h4ctar/motorbike-speedo/speedo-pcb/speedo-pcb.kicad_pcb

## KiCad design speedo-pcb/speedo-pcb.kicad_pcb (2025-04-23)

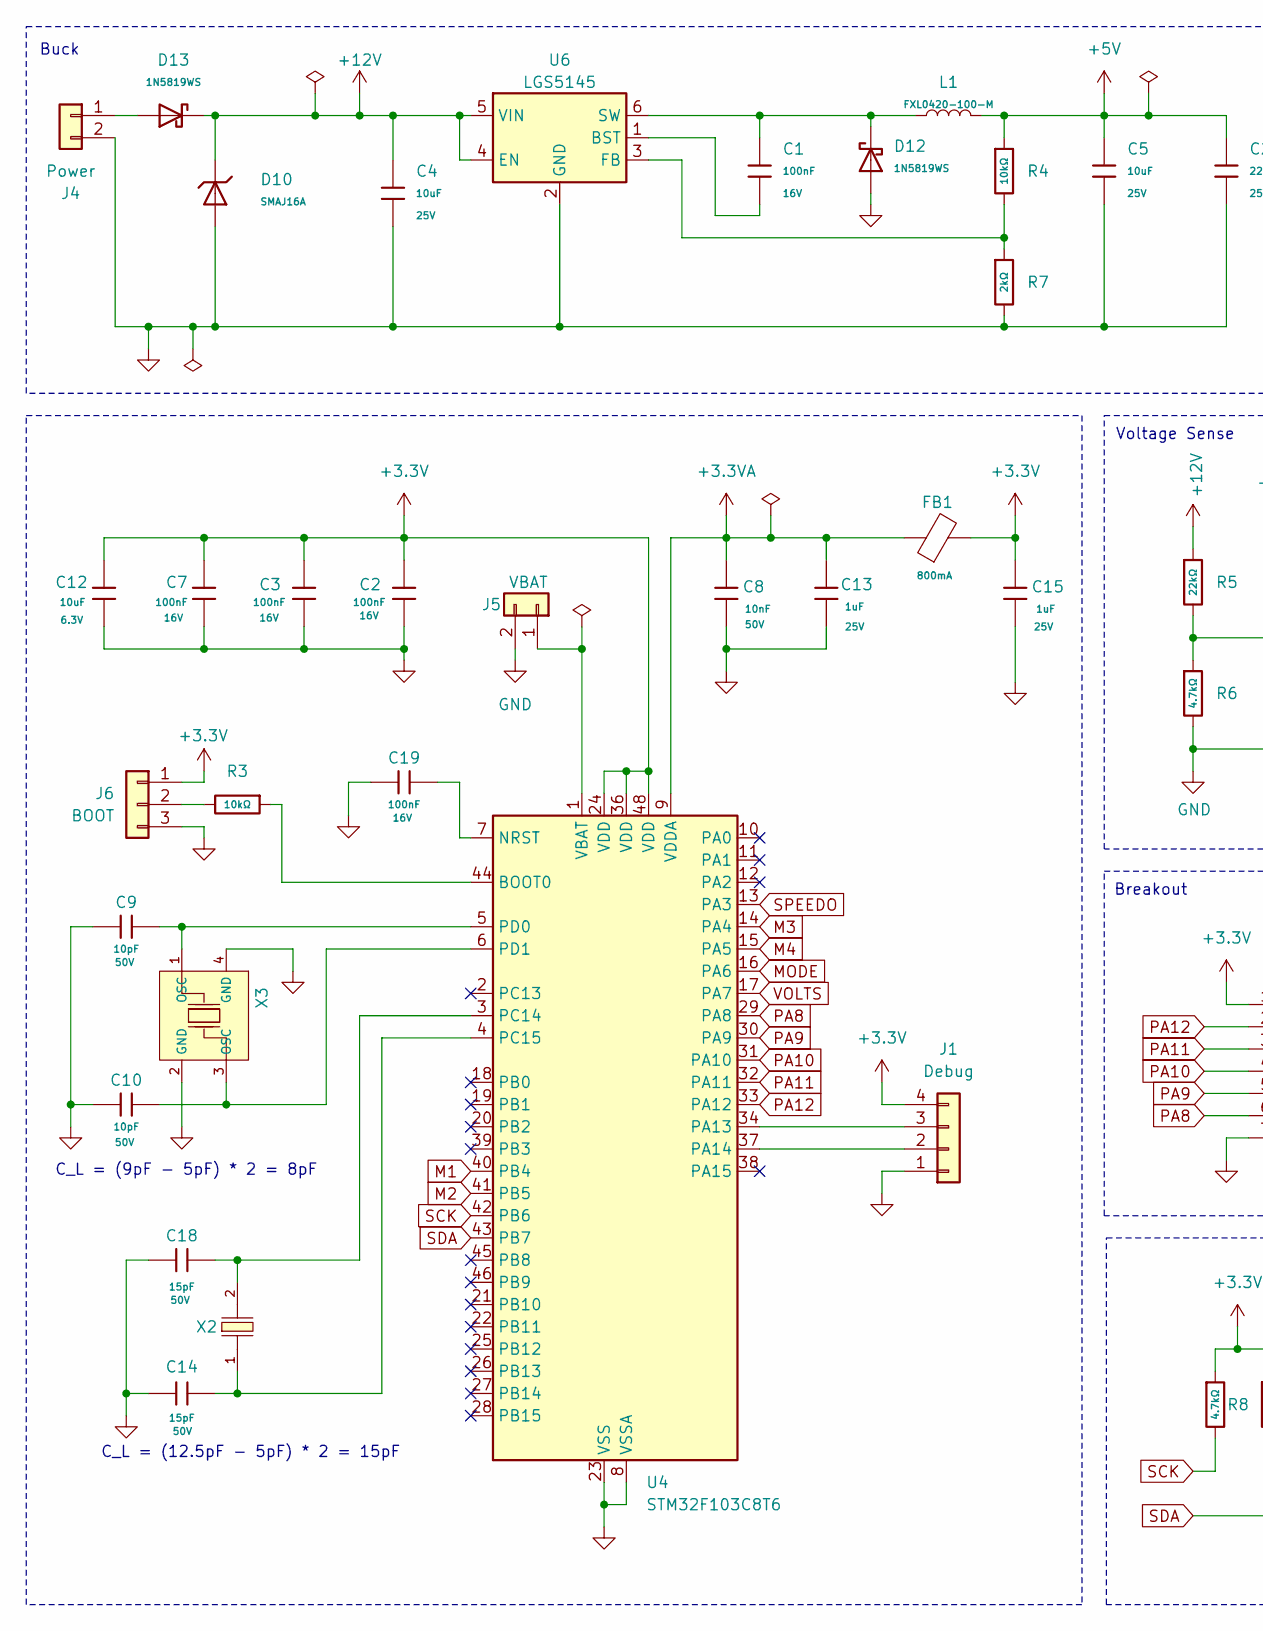
[picture p1: schematic speedo-pcb.kicad_sch, Motorcycle Speedo, part in row 1, column 1]

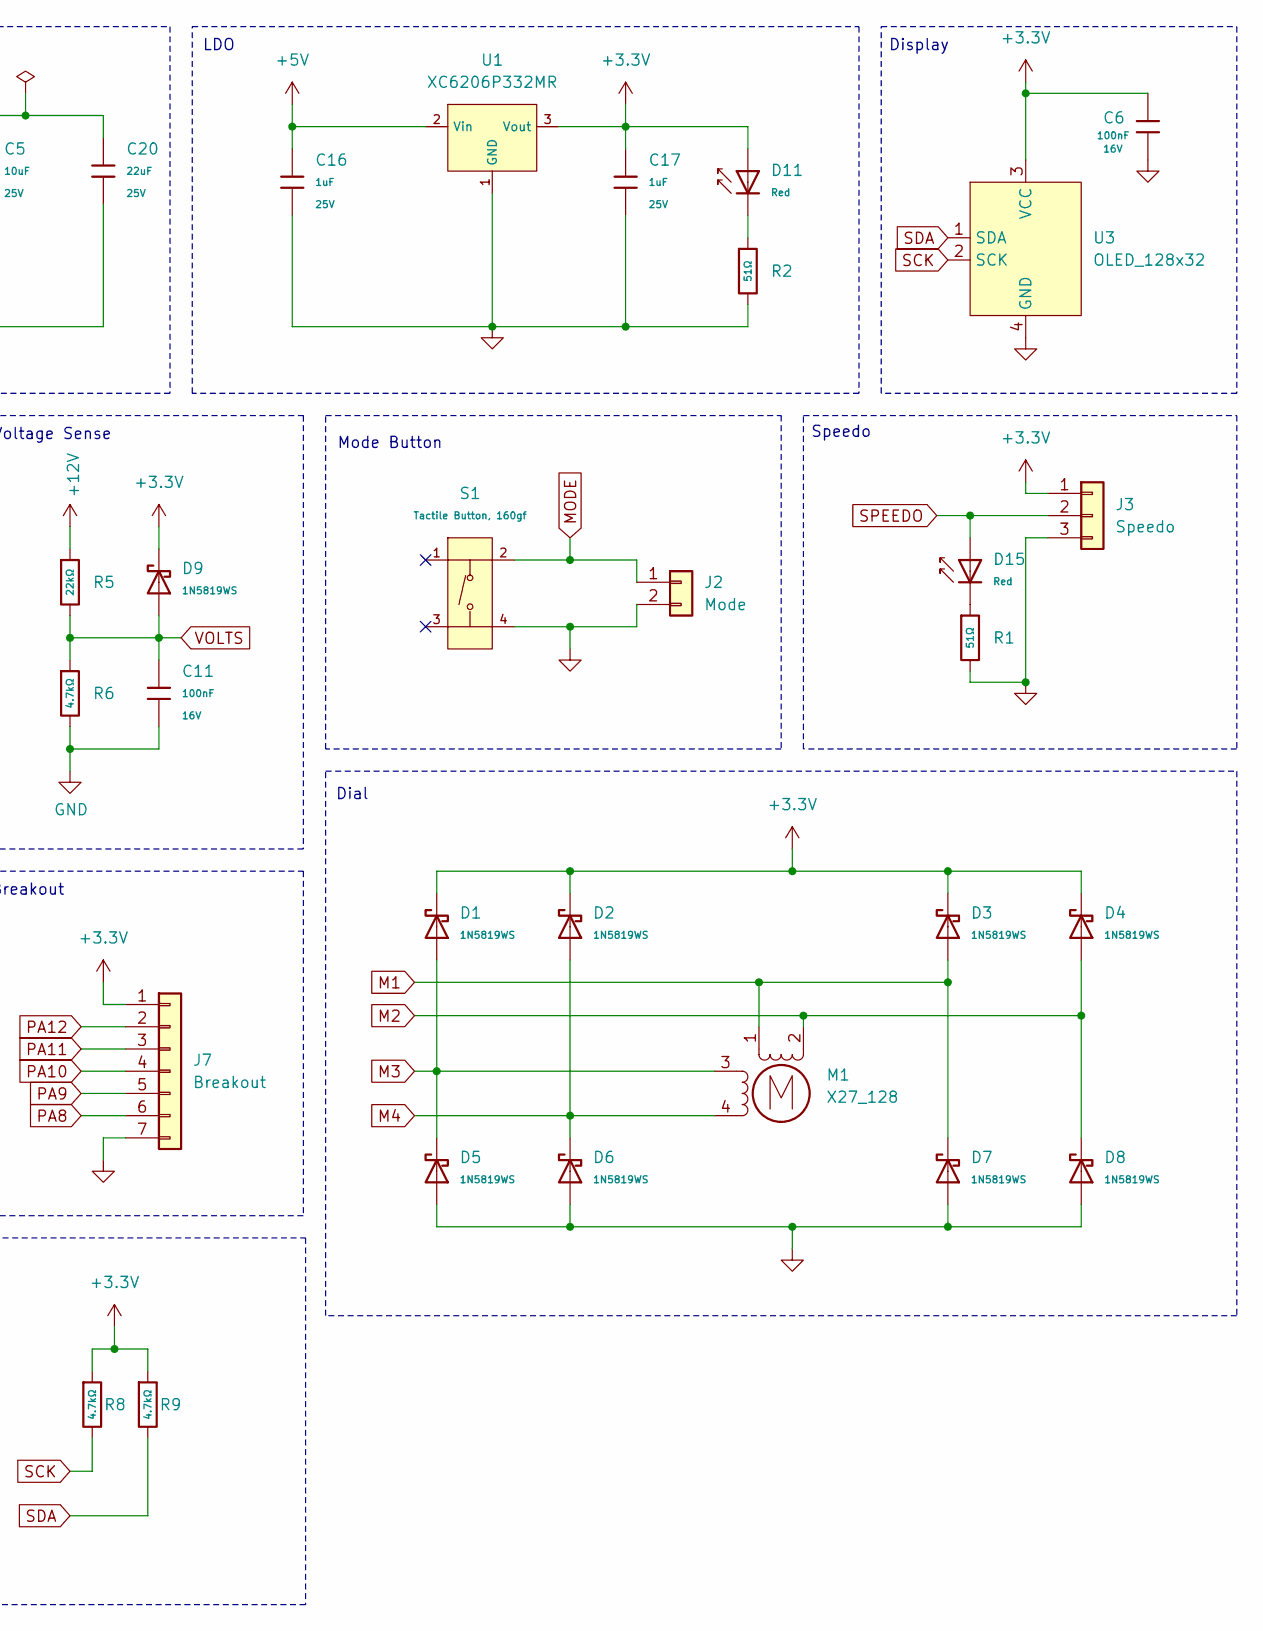
[picture p2: schematic speedo-pcb.kicad_sch, Motorcycle Speedo, part in row 1, column 2]

Parts:
C1, C2, C3, C6, C7, C11, C19: 100nF; C_0402; Voltage Rated 16V; Tolerance ±10%; Part CL05B104KO5NNNC; LCSC C1525
C4, C5: 10uF; C_0805; Voltage Rated 25V; Tolerance ±10%; Part CL21A106KAYNNNE; LCSC C15850
C8: 10nF; C_0402; Voltage Rated 50V; Tolerance ±10%; Part CL05B103KB5NNNC; LCSC C15195
C9, C10: 10pF; C_0402; Voltage Rated 50V; Tolerance ±5%; Part CL05C100JB5NNNC; LCSC C32949
C12: 10uF; C_0402; Voltage Rated 6.3V; Tolerance ±20%; Part CL05A106MQ5NUNC; LCSC C15525
C13, C15, C16, C17: 1uF; C_0402; Voltage Rated 25V; Tolerance ±10%; Part CL05A105KA5NQNC; LCSC C52923
C14, C18: 15pF; C_0402; Voltage Rated 50V; Tolerance ±5%; Part 0402CG150J500NT; LCSC C1548
C20: 22uF; C_0805; Voltage Rated 25V; Tolerance ±20%; Part CL21A226MAQNNNE; LCSC C45783
D1, D2, D3, D4, D5, D6, D7, D8, D9, D12, D13: 1N5819WS; D_SOD-323; Forward Voltage (Vf@If) 600mV@1A; Reverse Voltage (Vr) 40V; Part 1N5819WS; LCSC C191023
D10: SMAJ16A; D_SMA; Breakdown Voltage 19.7V; Part SMAJ16A; LCSC C41376405
D11, D15: Red; D_0603; Part KT-0603R; LCSC C2286
FB1: FB_0805; Current Rating 800mA; Tolerance ±25%; Part GZ2012D101TF; LCSC C1015
J1: Debug; PinHeader_1x04_P2.54mm_Vertical
J2: Mode; JST_PH_B2B-PH-K_1x02_P2.00mm_Vertical
J3: Speedo; JST_PH_B3B-PH-K_1x03_P2.00mm_Vertical
J4: Power; JST_PH_B2B-PH-K_1x02_P2.00mm_Vertical
J5: VBAT; JST_PH_B2B-PH-K_1x02_P2.00mm_Vertical
J6: BOOT; PinHeader_1x03_P2.54mm_Vertical
J7: Breakout; PinSocket_1x07_P2.54mm_Vertical
L1: FXL0420-100-M; L_Sunlord_MWSA0402S; LCSC C177242
M1: X27_128; X27_168
R1, R2: 51Ω; R_0402; Overload Voltage (Max) 50V; Tolerance ±1%; Part 0402WGF510JTCE; LCSC C25125
R3, R4: 10kΩ; R_0402; Overload Voltage (Max) 50V; Tolerance ±1%; Part 0402WGF1002TCE; LCSC C25744
R5: 22kΩ; R_0402; Overload Voltage (Max) 50V; Tolerance ±1%; Part 0402WGF2202TCE; LCSC C25768
R6, R8, R9: 4.7kΩ; R_0402; Overload Voltage (Max) 50V; Tolerance ±1%; Part 0402WGF4701TCE; LCSC C25900
R7: 2kΩ; R_0402; Overload Voltage (Max) 50V; Tolerance ±1%; Part 0402WGF2001TCE; LCSC C4109
S1: Tactile Button, 160gf; SW-SMD_4P-L5.1-W5.1-P3.70-LS6.5-TL-2; Voltage Rating (Dc) 12V; Part TS-1187A-B-A-B; LCSC C318884
U1: XC6206P332MR; SOT-23-3_L2.9-W1.6-P1.90-LS2.8-BR; Output Voltage 3.3V; Dropout Voltage 680mV@(100mA); Part XC6206P332MR-G; LCSC C5446
U3: OLED_128x32; OLED_128_32
U4: STM32F103C8T6; LQFP-48_7x7mm_P0.5mm; Operating Voltage Range 2V~3.6V; Low Voltage Detection T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 2V~3.6V; Part STM32F103C8T6; LCSC C8734
U6: LGS5145; SOT-23-6; LCSC C5123971
X2: Q13FC1350000400; FC-135R_L3.2-W1.5; Frequency Tolerance ±20ppm; Part Q13FC13500004; LCSC C32346
X3: X322516MLB4SI; OSC-SMD_4P-L3.2-W2.5-BL; Frequency Tolerance ±10ppm; Part X322516MLB4SI; LCSC C13738

Connections:
+3.3V: C2.1, C3.1, C6.1, C7.1, C12.1, C15.1, C17.1, D1.1, D2.1, D3.1, D4.1, D9.1, D11.2, FB1.2, J1.4, J3.1, J6.1, J7.1, R8.1, R9.1, U1.3 (Vout), U3.3 (VCC), U4.24 (VDD), U4.36 (VDD), U4.48 (VDD)
+3.3VA: C8.1, C13.1, FB1.1, U4.9 (VDDA)
+5V: C5.1, C16.1, C20.1, L1.2, R4.1, U1.2 (Vin)
+12V: C4.1, D10.1, D13.1, R5.1, U6.4 (EN), U6.5 (VIN)
GND: C2.2, C3.2, C4.2, C5.2, C6.2, C7.2, C8.2, C9.1, C10.1, C11.2, C12.2, C13.2, C14.1, C15.2, C16.2, C17.2, C18.1, C19.1, C20.2, D5.2, D6.2, D7.2, D8.2, D10.2, D12.2, J1.1, J2.2, J3.3, J4.2, J5.2, J6.3, J7.7, R1.2, R2.2, R6.2, R7.2, S1.4 (D), U1.1 (GND), U3.4 (GND), U4.8 (VSSA), U4.23 (VSS), U4.35 (VSS), U4.47 (VSS), U6.2 (GND), X3.2 (GND), X3.4 (GND)
M1: D3.2, D7.1, M1.1, U4.40 (PB4)
M2: D4.2, D8.1, M1.2 (-), U4.41 (PB5)
M3: D1.2, D5.1, M1.3, U4.14 (PA4)
M4: D2.2, D6.1, M1.4, U4.15 (PA5)
MODE: J2.1, S1.2 (B), U4.16 (PA6)
unnamed: D11.1, R2.1
unnamed: D15.1, R1.1
unnamed: J1.2, U4.37 (PA14)
unnamed: J1.3, U4.34 (PA13)
unnamed: D13.2, J4.1
unnamed: J5.1, U4.1 (VBAT)
unnamed: J6.2, R3.2
unnamed: R3.1, U4.44 (BOOT0)
unnamed: C19.2, U4.7 (NRST)
unnamed: C18.2, U4.3 (PC14), X2.2
unnamed: C14.2, U4.4 (PC15), X2.1
unnamed: C9.2, U4.5 (PD0), X3.1 (OSC)
unnamed: C10.2, U4.6 (PD1), X3.3 (OSC)
unnamed: C1.1, U6.1 (BST)
unnamed: R4.2, R7.1, U6.3 (FB)
unnamed: C1.2, D12.1, L1.1, U6.6 (SW)
PA8: J7.6, U4.29 (PA8)
PA9: J7.5, U4.30 (PA9)
PA10: J7.4, U4.31 (PA10)
PA11: J7.3, U4.32 (PA11)
PA12: J7.2, U4.33 (PA12)
SCK: R8.2, U3.2 (SCK), U4.42 (PB6)
SDA: R9.2, U3.1 (SDA), U4.43 (PB7)
SPEEDO: D15.2, J3.2, U4.13 (PA3)
VOLTS: C11.1, D9.2, R5.2, R6.1, U4.17 (PA7)

Notes on the sheet:
LDO
Dial
Speedo
C_L = (9pF - 5pF) * 2 = 8pF
C_L = (12.5pF - 5pF) * 2 = 15pF
Display
Buck
Breakout
Mode Button
Voltage Sense

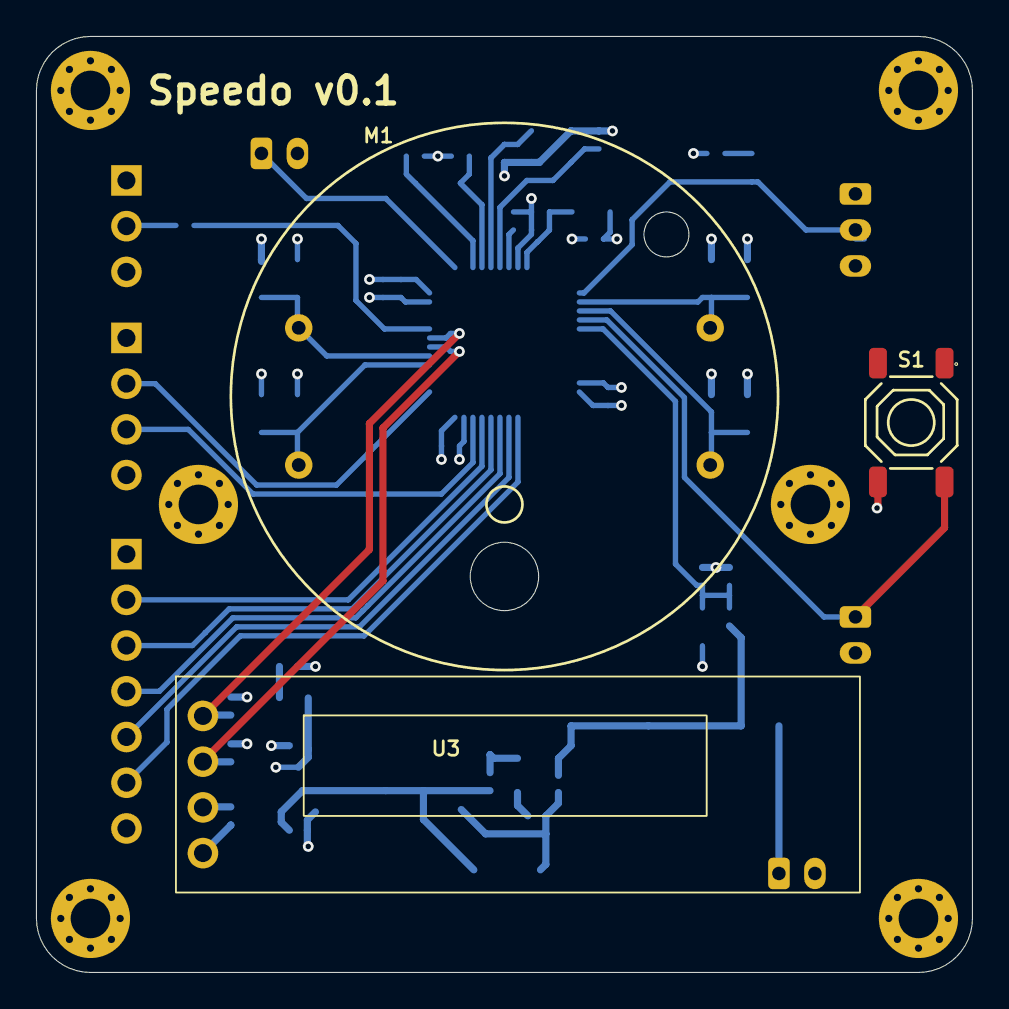
[picture p3: board speedo-pcb.kicad_pcb from above]

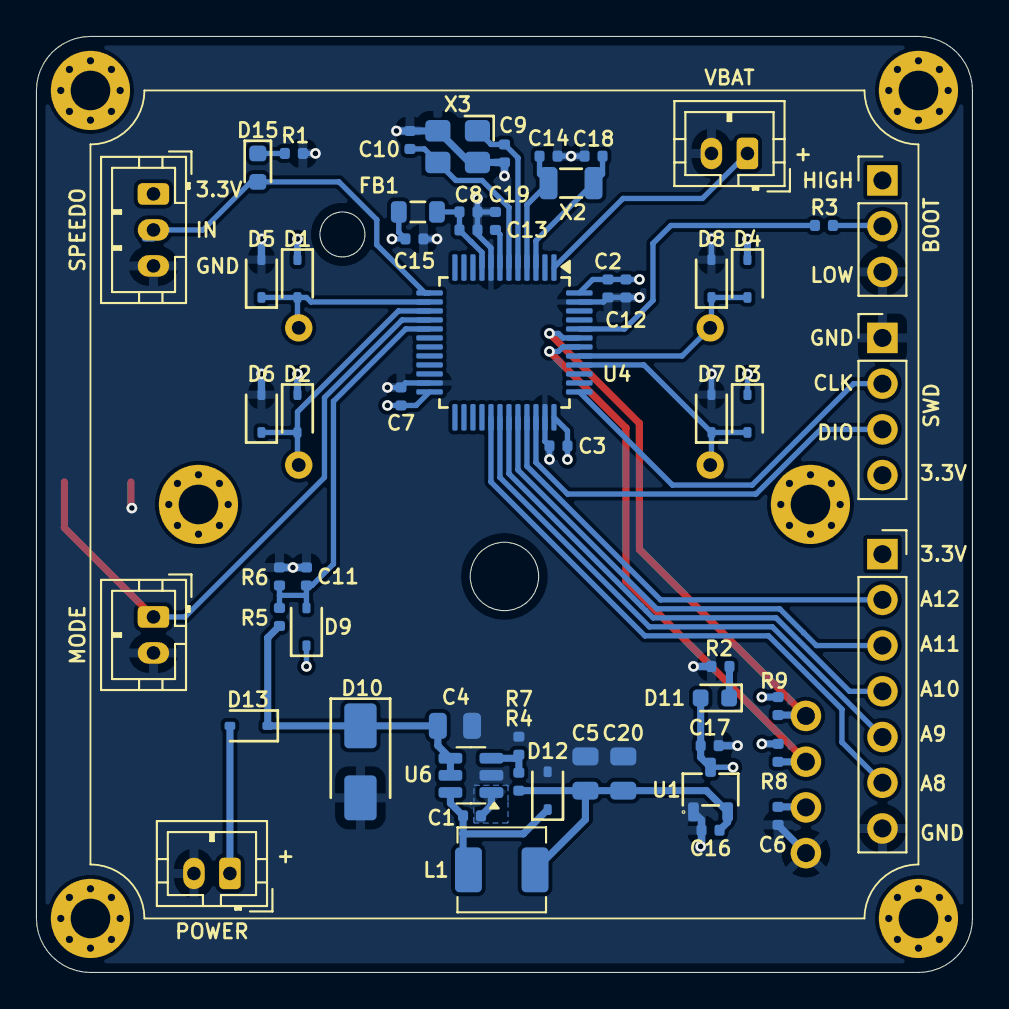
[picture p4: board speedo-pcb.kicad_pcb from below]

Board: 4 copper layers, 52.0 x 52.0 mm, 60 parts (57 on the bottom side), 35 nets.
