h4ctar/motorbike-speedo/(commit log)

2025-02-03 first draft
    [speedo-pcb.kicad_pcb, speedo-pcb.kicad_sch]
2025-02-04 fix 3d model paths
    [speedo-pcb.kicad_pcb]
2025-02-07 fix broken courtyard
    [speedo-pcb.kicad_pcb]
2025-02-07 filter lib footprint and lib symbol issues
2025-02-07 pcbdraw name
2025-02-07 fix erc and drc filters
2025-02-07 pcbdraw back
2025-02-09 buck converter and tvs
    [speedo-pcb.kicad_pcb, speedo-pcb.kicad_sch]
2025-02-09 buck converter fills
    [speedo-pcb.kicad_pcb, speedo-pcb.kicad_sch]
2025-02-09 fixed schematic overlapping text
    [speedo-pcb.kicad_sch]
2025-02-09 fix drc issue
    [speedo-pcb.kicad_pcb]
2025-02-10 change tvs
    [speedo-pcb.kicad_pcb, speedo-pcb.kicad_sch]
2025-02-11 fix buck en pin
    [speedo-pcb.kicad_pcb, speedo-pcb.kicad_sch]
2025-04-11 pcb cleanup
    [speedo-pcb.kicad_pcb, speedo-pcb.kicad_sch]
2025-04-17 oled decoupling capacitor and i2c pull up resistors
    [speedo-pcb.kicad_pcb, speedo-pcb.kicad_sch]
2025-04-23 u6 lcsc
    [speedo-pcb.kicad_sch]
2025-04-23 fix resistor footprint type
    [speedo-pcb.kicad_pcb]
2025-04-23 pcb clean up
    [speedo-pcb.kicad_pcb]
