h4ctar/motorbike-speedo/(notices)

Notices in the files:
speedo-code/Core/Inc/main.h:
Copyright (c) 2025 STMicroelectronics.
All rights reserved.
This software is licensed under terms that can be found in the LICENSE file
